ionutz04/REST-API-server-implementation-using-self-signed-https-certificates/camera-monitor/snapshot_20260423_095013.png

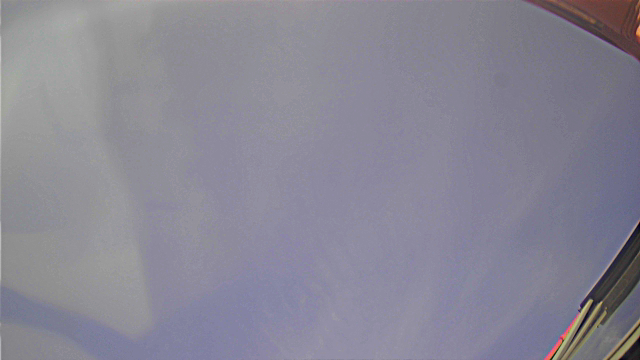
camera-monitor/snapshot_20260423_095013.png
