ionutz04/REST-API-server-implementation-using-self-signed-https-certificates/images/ms2.png

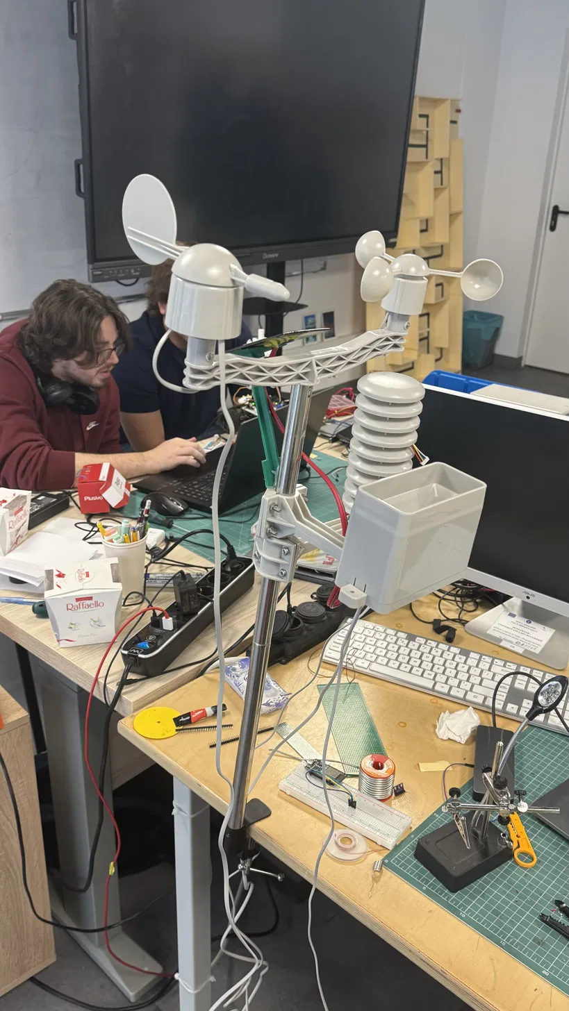
images/ms2.png
