ionutz04/REST-API-server-implementation-using-self-signed-https-certificates/forecasting/debug_plots_multihead/temperature_forecast_test.png

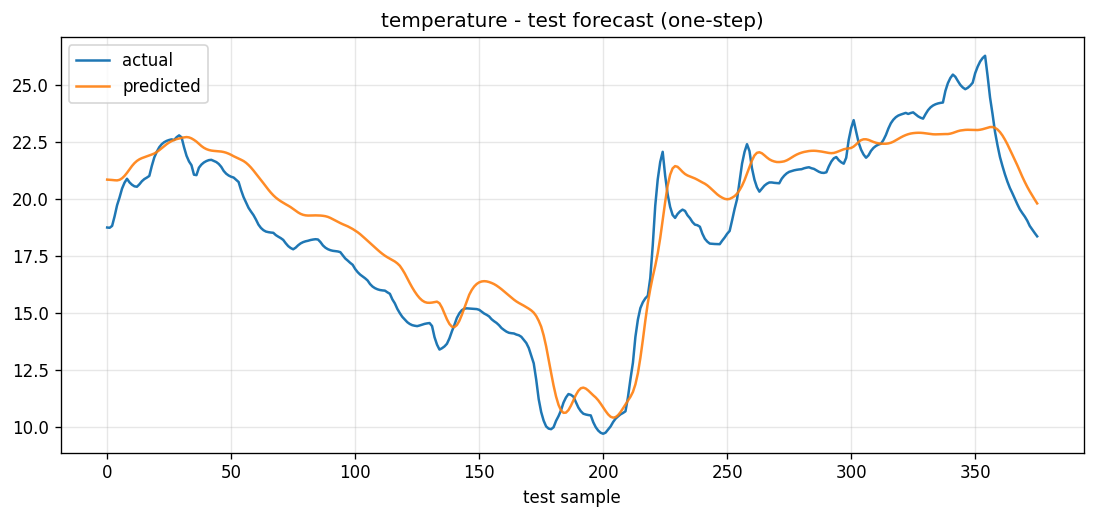
forecasting/debug_plots_multihead/temperature_forecast_test.png
