ionutz04/REST-API-server-implementation-using-self-signed-https-certificates/forecasting/debug_plots_multihead/humidity_vs_temp_scatter.png

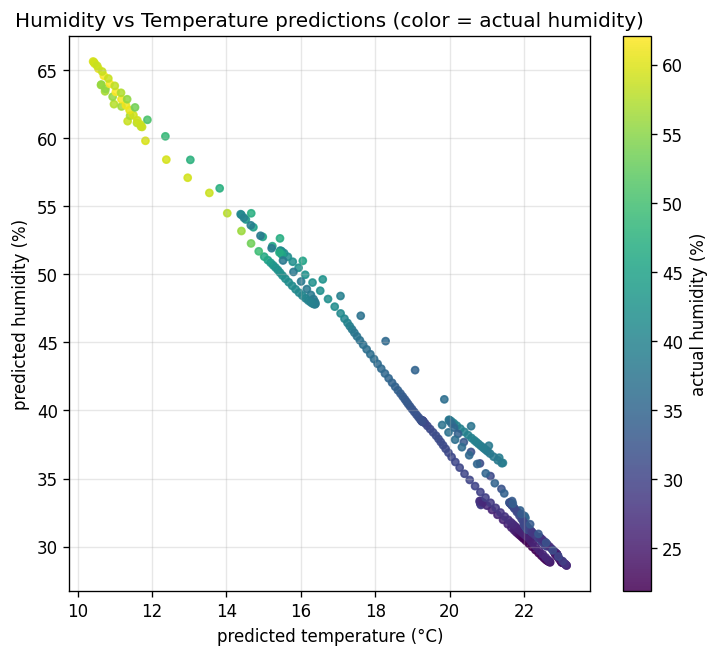
forecasting/debug_plots_multihead/humidity_vs_temp_scatter.png
