ionutz04/REST-API-server-implementation-using-self-signed-https-certificates/forecasting/debug_plots_multihead/pressure_entire_series_prediction.png

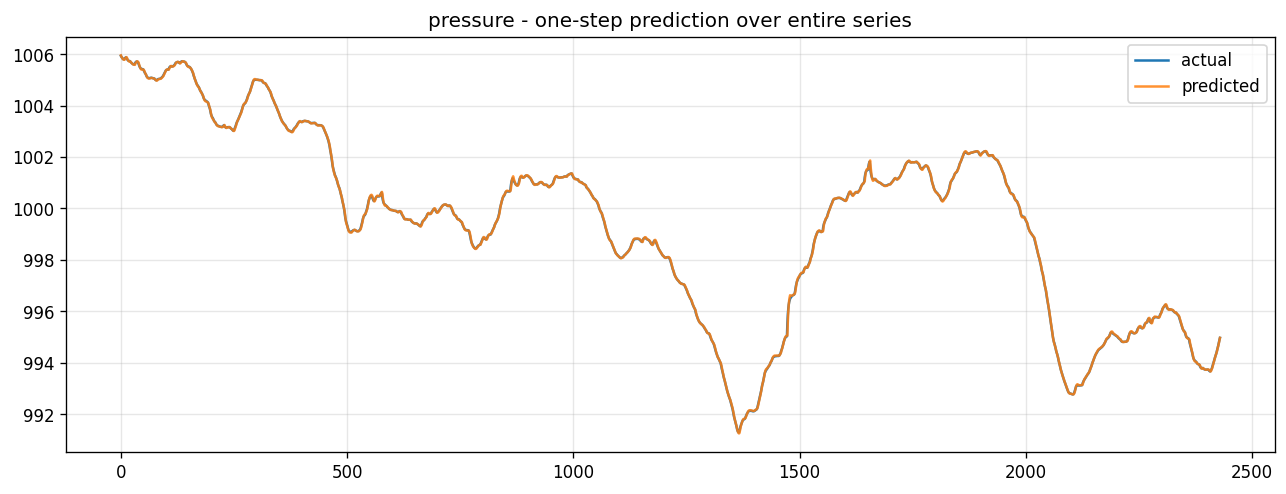
forecasting/debug_plots_multihead/pressure_entire_series_prediction.png
