ionutz04/REST-API-server-implementation-using-self-signed-https-certificates/forecasting/debug_plots_multihead/pressure_linear_coeffs.png

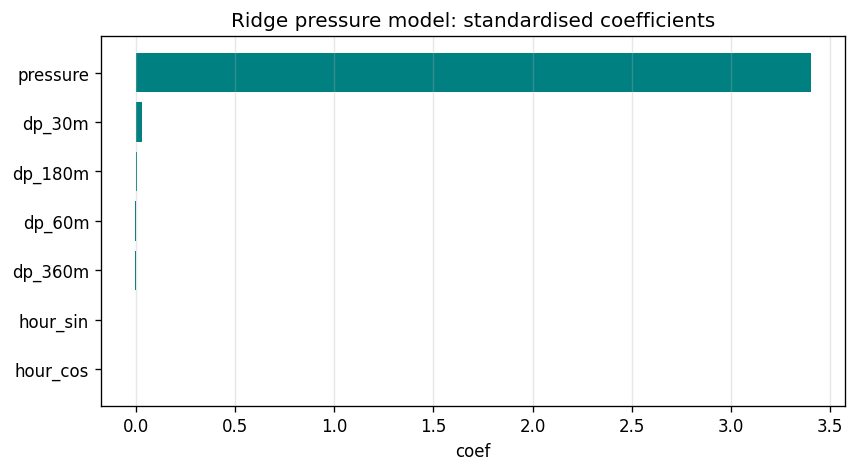
forecasting/debug_plots_multihead/pressure_linear_coeffs.png
