ionutz04/REST-API-server-implementation-using-self-signed-https-certificates/forecasting/debug_plots_multihead/training_loss.png

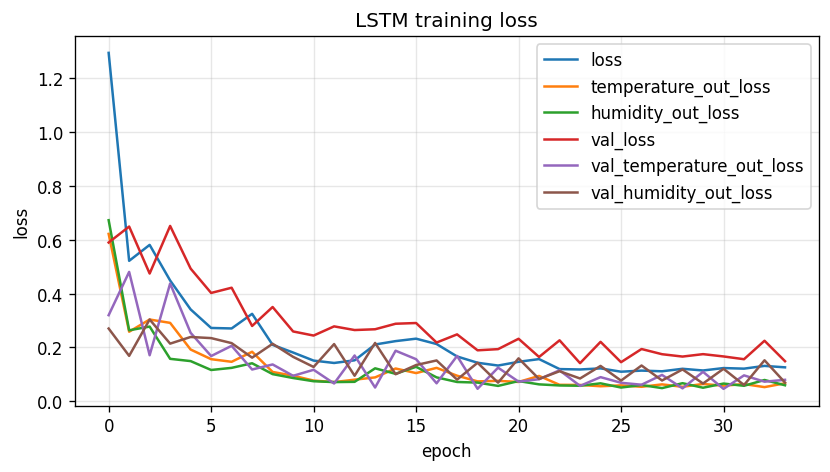
forecasting/debug_plots_multihead/training_loss.png
